guitarrista672f/autovent_tt3/Reporte.pdf

Reason for the project:
Has been required to implement functionality to handle auto vents in a rotatory table TT3 due to new production demands.

Resolution:
The first option was to try to activate this functionality using the native resources of the system but I could not find a functional way to do it because it needs to access the plc and there is no software available
for this task.

A second option was to use an external system. It could be independent of the PLC, but linked to the necessary conditions relating to the carrier stations that allow recreating safely the auto vent functionality.

After analyzing the requirements and having determined the number of inputs and outputs necessary to control the required system, I selected to build an electronic circuit using a little microcontroller such as the ATTiny85 with enough capacity for this task.

- Receiving signals from the lid when it opens completely and from the airbag when it is in a down position.
- Handles an electro-pneumatic valve(this valve will control the auto vents air flows).

This microcontroller will be provided with the necessary interfaces for:

To facilitate the construction of the circuit, I designed a pc board.
Another benefit of having a PC-board is,to make the troubleshooting easier, in case it is needed in the future.

Costs.

- The time required to prepare one unit is around 2 hours.
- Initially, for this project, I spent around 10 hours to design, research, make prototypes, and testing.

The approximate cost for producing one unit is around 33.00 dollars.

Note: Because many of the materials that are necessary for this project are only available in packages of more than one unit, the initial cost is a little higher but this extra material can be saved to build future devices or used in other projects.

# Introduction: AUTO VENT TT3 PROJECT

Wednesday, September 01, 2021 10:54 AM

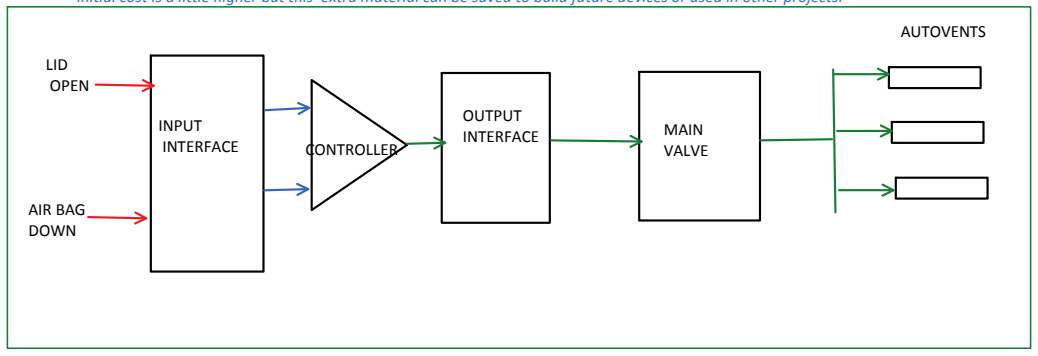
[picture p1: figure]
INPUT INTERFACE; OUTPUT; INTERFACE; MAIN; VALVE; AUTOVENTS; CONTROLLER; LID OPEN; AIR BAG DOWN

Introduction Page 1

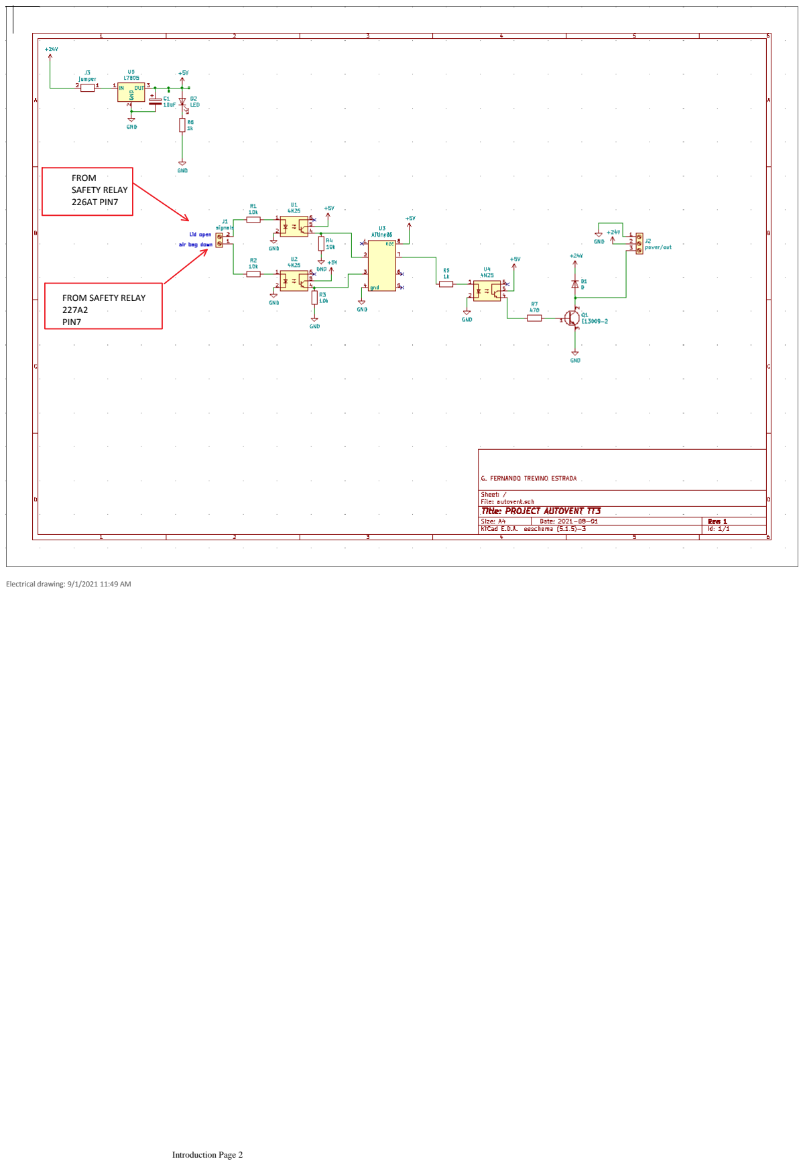
[picture p2: page 2]

Electrical drawing: 9/1/2021 11:49 AM

FROM
SAFETY RELAY
226AT PIN7

FROM SAFETY RELAY
227A2
PIN7

Introduction Page 2

## PC board design

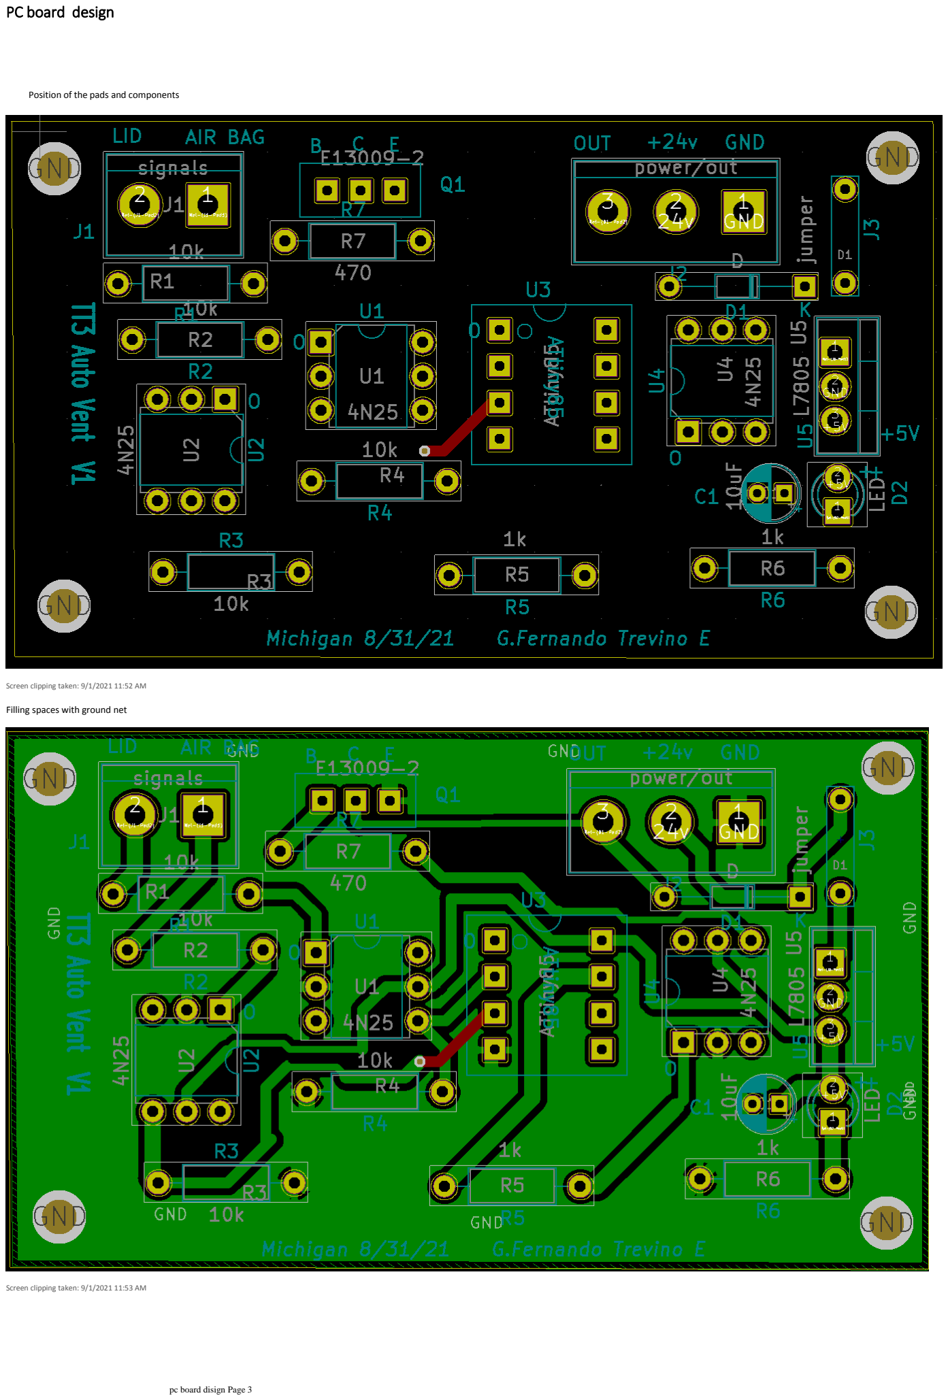
[picture p3: page 3]

Screen clipping taken: 9/1/2021 11:52 AM

Filling spaces with ground net

Screen clipping taken: 9/1/2021 11:53 AM

Position of the pads and components

pc board disign Page 3

This is a simulation of the card with some of the electrical components.

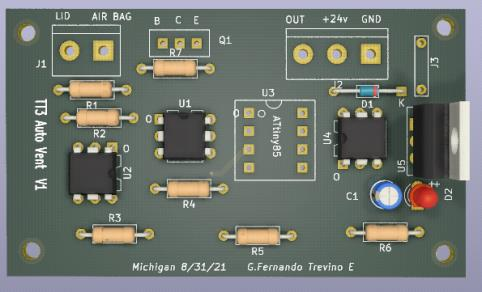
[picture p4: figure]

Screen clipping taken: 9/1/2021 11:54 AM

The card was sent to PCBWay for manufacturing(China).

Here the Real card with all the components assembled except the controller in a preliminary test.

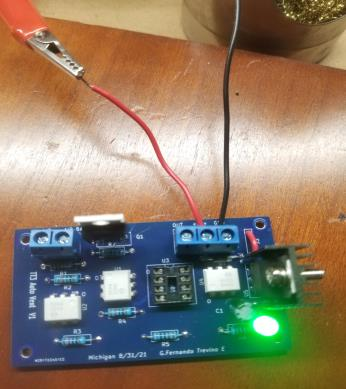
[picture p5: figure]

pc board disign Page 4

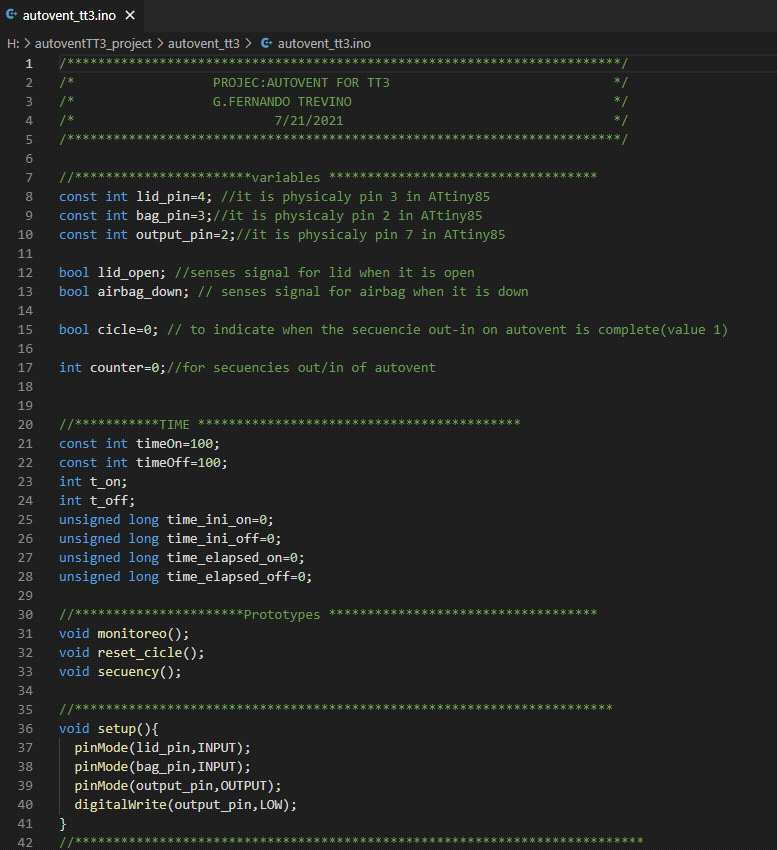
[picture p6: figure]

Screen clipping taken: 9/1/2021 12:05 PM

### Next is the code I wrote for programming the micro controller:

I used other arduino as a serial programmer for load the program inside the ATTiny85.

Wednesday, September 01, 2021 12:01 PM

Programming Page 5

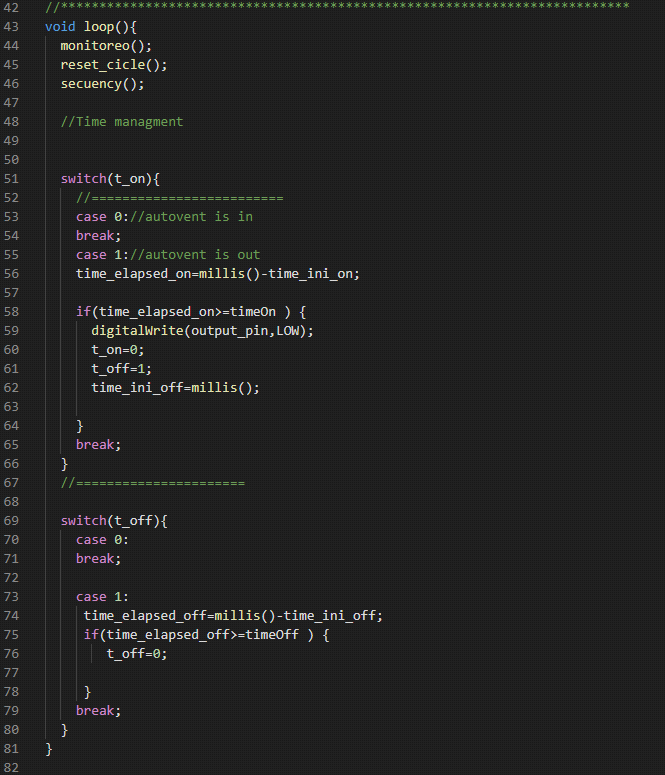
[picture p7: figure]

Screen clipping taken: 9/1/2021 12:06 PM

Programming Page 6

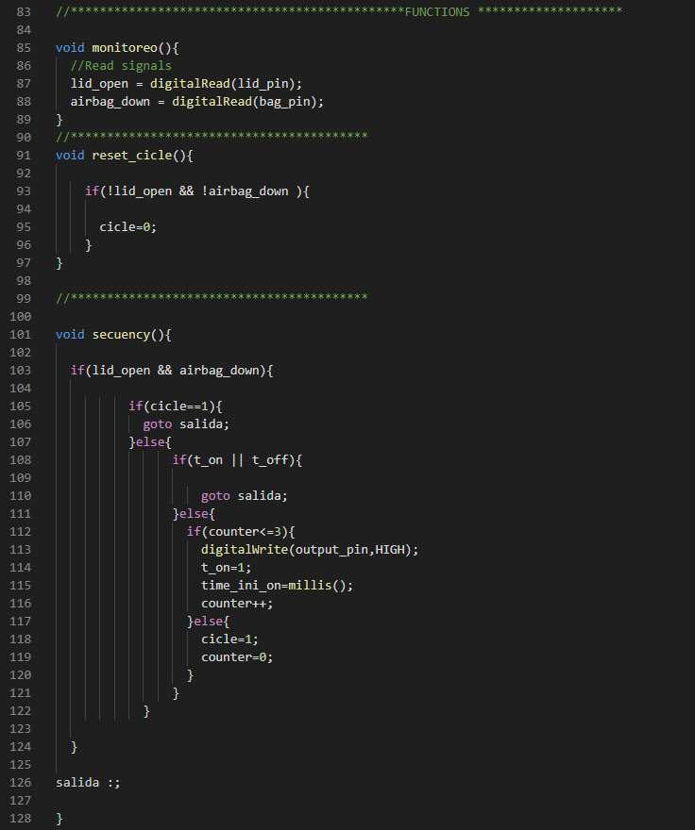
[picture p8: figure]

Screen clipping taken: 9/1/2021 12:07 PM

Programming Page 7

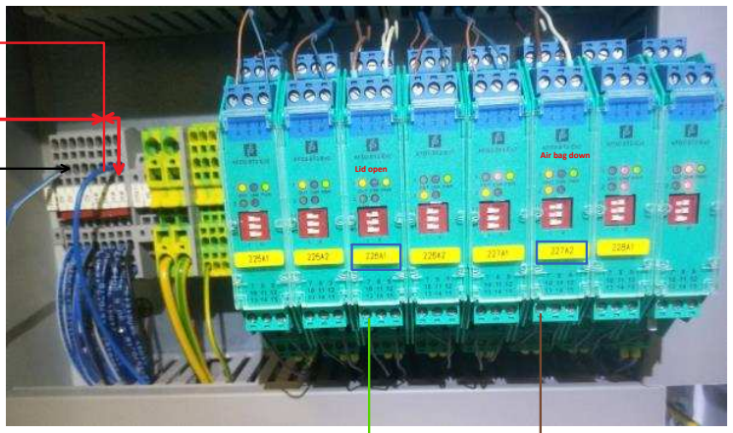
[picture p9: figure]
Air bag down; Lid open

Take
negative and
+24 volts from here

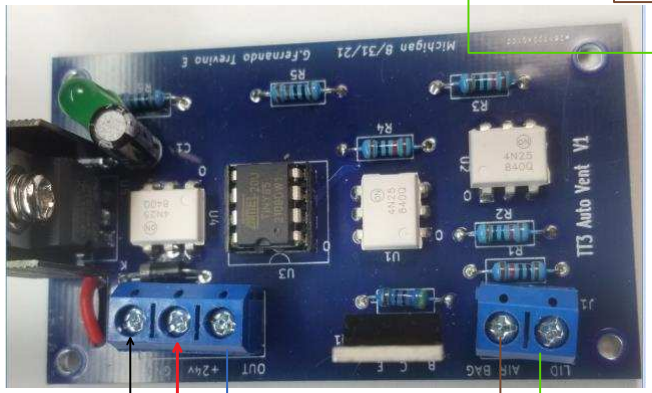
[picture p10: figure]

Screen clipping taken: 9/9/2021 10:56 AM

Electro pneumatic valve

SAFETY RELAYS MODULE

How to connect the card

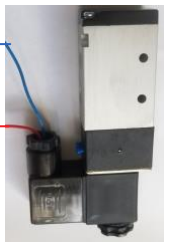
[picture p11: figure]
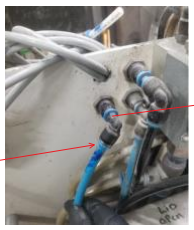
[picture p12: figure]

Air source: was used this hose output

Outputs
To auto vents

Screen clipping taken: 9/9/2021 12:25 PM

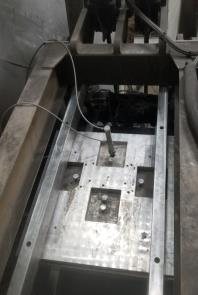
[picture p13: figure]

First prototype:
Autovent installed in mold of station#8

Wednesday, September 01, 2021 12:33 PM

how to connect the card and the valve Page 8
